apparentlymart/failinator/client/README.md

Failinator Client
=================

The *client* portion of Failinator is what runs on the Raspberry Pi and controls
the devices on the custom PCB.

It connects to the server to recieve push notifications of data via a
websocket connection.
