apparentlymart/failinator/pcb/failinator.kicad_pcb

## KiCad design pcb/failinator.kicad_pcb (2016-02-22)

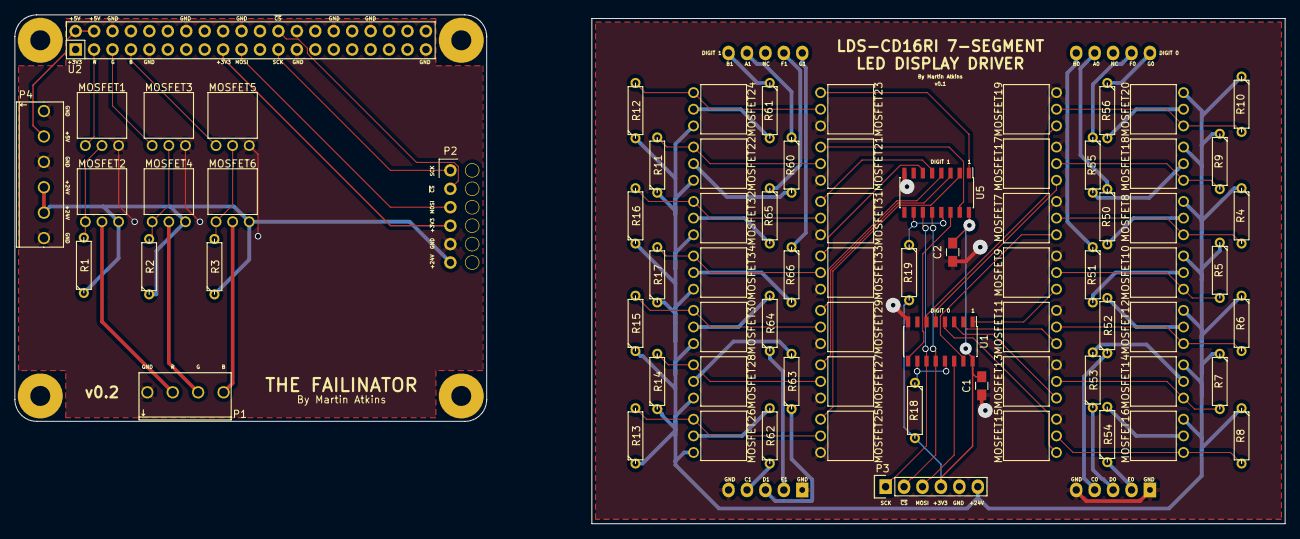
[picture p1: board failinator.kicad_pcb from above]

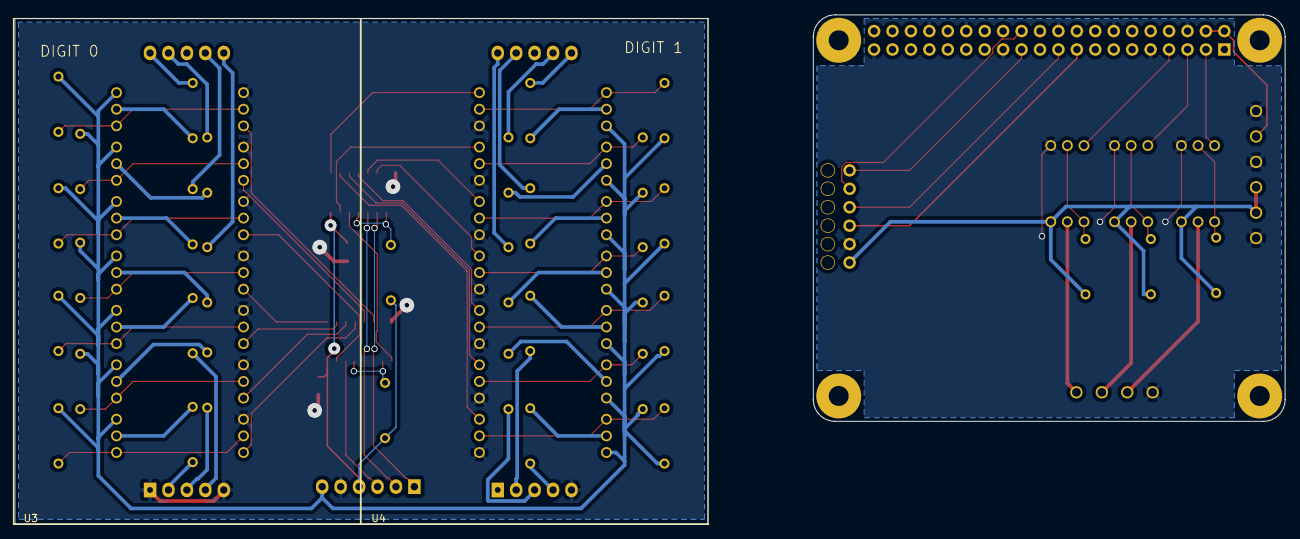
[picture p2: board failinator.kicad_pcb from below]

Board: 2 copper layers, 175.0 x 70.1 mm, 82 parts (2 on the bottom side), 81 nets.

Parts:
C1, C2: C_Small; C_0805_HandSoldering
MOSFET1, MOSFET3, MOSFET5, MOSFET7, MOSFET9, MOSFET11, MOSFET13, MOSFET15, MOSFET17, MOSFET19, MOSFET21, MOSFET23, MOSFET25, MOSFET27, MOSFET29, MOSFET31, MOSFET33: FQU13N06L; TO-251AA
MOSFET2, MOSFET4, MOSFET6, MOSFET8, MOSFET10, MOSFET12, MOSFET14, MOSFET16, MOSFET18, MOSFET20, MOSFET22, MOSFET24, MOSFET26, MOSFET28, MOSFET30, MOSFET32, MOSFET34: FQU17P06; TO-251AA
Mounting_Hole_2.75mm, Mounting_Hole_2.75mm#2, Mounting_Hole_2.75mm#3, Mounting_Hole_2.75mm#4: VAL**; Mounting_Hole_2.75mm
P1: CONN_01X04; TERM_4
P2: CONN_01X06; Wire_Conn_6pin_StrainReliefRight
P3: CONN_01X06; Pin_Header_Straight_1x06
P4: CONN_01X06; TERM_6
R1, R2, R3, R4, R5, R6, R7, R8, R9, R10, R11, R12, R13, R14, R15, R16, R17, R18, R19: 10k; R3
R50, R51, R52, R53, R54, R55, R56, R60, R61, R62, R63, R64, R65, R66: 150; R3
U1, U5: 74HC594; SOIC-16_3.9x9.9mm_Pitch1.27mm
U2: RASPIPLUSHEADER; Pin_Header_Straight_2x20
U3, U4: LDS-CD16RI

Connections:
+3V3: P2.4, U2.1, U2.17
+5V: P4.2, U2.2, U2.4
+24V: MOSFET2.3, MOSFET4.3, MOSFET6.3, P2.6, P4.4, P4.5, R1.1, R2.1, R3.1
/AmberDriver/EN: MOSFET3.1, U2.5
/AmberDriver/VOUT: MOSFET4.2, P1.3
/DISP_CS: P2.2, U2.24
/D_+3V3: C1.2, C2.2, P3.4, R18.2, R19.2, U1.16, U5.16
/D_DISP_CS: P3.2, U1.12, U5.12
/D_MOSI: P3.3, U1.14
/D_SCLK: P3.1, U1.11, U5.11
/DisplayDrivers/A0Driver/VOUT: MOSFET8.2, R50.2
/DisplayDrivers/A0_L: MOSFET7.1, U1.15
/DisplayDrivers/A0_P: R50.1, U3.7
/DisplayDrivers/A1Driver/VOUT: MOSFET22.2, R60.2
/DisplayDrivers/A1_L: MOSFET21.1, U5.15
/DisplayDrivers/A1_P: R60.1, U4.7
/DisplayDrivers/B0Driver/VOUT: MOSFET10.2, R51.2
/DisplayDrivers/B0_L: MOSFET9.1, U1.1
/DisplayDrivers/B0_P: R51.1, U3.6
/DisplayDrivers/B1Driver/VOUT: MOSFET24.2, R61.2
/DisplayDrivers/B1_L: MOSFET23.1, U5.1
/DisplayDrivers/B1_P: R61.1, U4.6
/DisplayDrivers/C0Driver/VOUT: MOSFET12.2, R52.2
/DisplayDrivers/C0_L: MOSFET11.1, U1.2
/DisplayDrivers/C0_P: R52.1, U3.4
/DisplayDrivers/C1Driver/VOUT: MOSFET26.2, R62.2
/DisplayDrivers/C1_L: MOSFET25.1, U5.2
/DisplayDrivers/C1_P: R62.1, U4.4
/DisplayDrivers/D0Driver/VOUT: MOSFET14.2, R53.2
/DisplayDrivers/D0_L: MOSFET13.1, U1.3
/DisplayDrivers/D0_P: R53.1, U3.3
/DisplayDrivers/D1Driver/VOUT: MOSFET28.2, R63.2
/DisplayDrivers/D1_L: MOSFET27.1, U5.3
/DisplayDrivers/D1_P: R63.1, U4.3
/DisplayDrivers/E0Driver/VOUT: MOSFET16.2, R54.2
/DisplayDrivers/E0_L: MOSFET15.1, U1.4
/DisplayDrivers/E0_P: R54.1, U3.2
/DisplayDrivers/E1Driver/VOUT: MOSFET30.2, R64.2
/DisplayDrivers/E1_L: MOSFET29.1, U5.4
/DisplayDrivers/E1_P: R64.1, U4.2
/DisplayDrivers/F0Driver/VOUT: MOSFET18.2, R55.2
/DisplayDrivers/F0_L: MOSFET17.1, U1.5
/DisplayDrivers/F0_P: R55.1, U3.9
/DisplayDrivers/F1Driver/VOUT: MOSFET32.2, R65.2
/DisplayDrivers/F1_L: MOSFET31.1, U5.5
/DisplayDrivers/F1_P: R65.1, U4.9
/DisplayDrivers/G0Driver/VOUT: MOSFET20.2, R56.2
/DisplayDrivers/G0_L: MOSFET19.1, U1.6
/DisplayDrivers/G0_P: R56.1, U3.10
/DisplayDrivers/G1Driver/VOUT: MOSFET34.2, R66.2
/DisplayDrivers/G1_L: MOSFET33.1, U5.6
/DisplayDrivers/G1_P: R66.1, U4.10
/DisplayDrivers/GND: C1.1, C2.1, MOSFET7.3, MOSFET9.3, MOSFET11.3, MOSFET13.3, MOSFET15.3, MOSFET17.3, MOSFET19.3, MOSFET21.3, MOSFET23.3, MOSFET25.3, MOSFET27.3, MOSFET29.3, MOSFET31.3, MOSFET33.3, P3.5, U1.8, U3.1, U3.5, U4.1, U4.5, U5.8
/DisplayDrivers/VIN: MOSFET8.3, MOSFET10.3, MOSFET12.3, MOSFET14.3, MOSFET16.3, MOSFET18.3, MOSFET20.3, MOSFET22.3, MOSFET24.3, MOSFET26.3, MOSFET28.3, MOSFET30.3, MOSFET32.3, MOSFET34.3, P3.6, R4.1, R5.1, R6.1, R7.1, R8.1, R9.1, R10.1, R11.1, R12.1, R13.1, R14.1, R15.1, R16.1, R17.1
/GreenDriver/EN: MOSFET5.1, U2.7
/GreenDriver/VOUT: MOSFET6.2, P1.4
/MOSI: P2.3, U2.19
/RedDriver/EN: MOSFET1.1, U2.3
/RedDriver/VOUT: MOSFET2.2, P1.2
/SCLK: P2.1, U2.23
GND: MOSFET1.3, MOSFET3.3, MOSFET5.3, P1.1, P2.5, P4.1, P4.3, P4.6, U2.6, U2.9, U2.14, U2.20, U2.25, U2.30, U2.34, U2.39
unnamed: MOSFET1.2, MOSFET2.1, R1.2
unnamed: MOSFET3.2, MOSFET4.1, R2.2
unnamed: MOSFET5.2, MOSFET6.1, R3.2
unnamed: MOSFET7.2, MOSFET8.1, R4.2
unnamed: MOSFET9.2, MOSFET10.1, R5.2
unnamed: MOSFET11.2, MOSFET12.1, R6.2
unnamed: MOSFET13.2, MOSFET14.1, R7.2
unnamed: MOSFET15.2, MOSFET16.1, R8.2
unnamed: MOSFET17.2, MOSFET18.1, R9.2
unnamed: MOSFET19.2, MOSFET20.1, R10.2
unnamed: MOSFET21.2, MOSFET22.1, R11.2
unnamed: MOSFET23.2, MOSFET24.1, R12.2
unnamed: MOSFET25.2, MOSFET26.1, R13.2
unnamed: MOSFET27.2, MOSFET28.1, R14.2
unnamed: MOSFET29.2, MOSFET30.1, R15.2
unnamed: MOSFET31.2, MOSFET32.1, R16.2
unnamed: MOSFET33.2, MOSFET34.1, R17.2
unnamed: R18.1, U1.10, U1.13
unnamed: R19.1, U5.10, U5.13
unnamed: U1.9, U5.14
