apparentlymart/failinator/(commit log)

2015-09-25 KiCad project.
2015-09-25 Pi Hat PCB mounting hole footprint.
2015-09-25 Project-specific footprint library.
2015-09-25 Component footprint assignments and netlist.
    [failinator.sch]
2015-09-25 Initial PCB floorplan.
    [failinator.kicad_pcb]
2015-09-25 Swap the external lamp connections for easier PCB routing.
    [failinator.kicad_pcb, failinator.sch]
2015-09-25 Design rules and ground pour.
    [failinator.kicad_pcb]
2015-09-25 PCB tracks.
    [failinator.kicad_pcb]
2015-09-25 Silkscreen annotations.
    [failinator.kicad_pcb]
2015-09-25 Change LED display pinout for a different display.
    The other display was too expensive, so switching to a smaller one.
    [failinator.kicad_pcb, failinator.sch]
2015-09-25 Re-fill polygons.
    [failinator.kicad_pcb]
2015-10-09 webhooks & website
    - added a new webhooks endpoint to receive VO events
    - more website styling
    - trigger events from the website
    - switch website to jquery
    - turn off ws test client writes
    - fix some event logic
2016-01-02 CircuitJS model of new 7seg display driver design.
2016-01-02 Starting work on revision v0.2.
    [failinator.kicad_pcb, failinator.sch]
2016-01-02 Factor out the MOSFET switches into a separate sheet.
    There will be a lot more of these soon once we start using a similar
    pattern to switch the LED segments.
    [MOSFETDriver.sch, failinator.kicad_pcb, failinator.sch]
2016-01-02 Remove the MAX7219-based digit driver sub-circuit
    The digit driver on v0.1 was not correct, providing only 5V to LED
    segments that have a forward voltage of more like 27V, causing them to
    not show at all.
    A replacement for this will be added in a subsequent commit.
    [MOSFETDriver.sch, failinator.kicad_pcb, failinator.sch]
2016-01-02 Schematic symbol for 7-segment LED display
2016-01-02 Squeeze schematic layout to make more space.
    The 7 segment LED driver sub-circuits are going to take up a bunch of
    space.
    [MOSFETDriver.sch, failinator.sch]
2016-01-02 7-segment LED displays and their ground connections
    [failinator.sch]
2016-01-02 KiCad's ongoing fiddling with the shared component refs
    When using the same child schematic sheet multiple times, KiCad keeps
    updating the references to point to the last one that was viewed/edited.
    So this change doesn't actually do anything.
    [MOSFETDriver.sch]
2016-01-02 Connect the LED controller CS to RPi pin 24.
    In the v0.1 design this was erroneously connected to pin 22, which is not
    supported as a hardware SPI chip select. Pin 24 is SPI0_CE0_N, which is
    the chip select pin for the first (zeroth) SPI device on the primary SPI
    bus.
    [failinator.sch]
2016-01-02 Tweak layout of the "Status Lamp Control" area
    Just a minor cosmetic tweak to improve the visual balance.
    [failinator.sch]
2016-01-02 Title on the MOSFETDriver sheet
    [MOSFETDriver.sch]
2016-01-02 Random updates to the KiCad project file
2016-01-11 MOSFET driver circuits for the 7-segment displays
    [DisplayDrivers.sch, MOSFETDriver.sch, failinator.sch]
2016-01-11 74HC594 schematic symbol
2016-01-11 Shift registers for the 7-seg displays
    [failinator.sch]
2016-02-21 Display board connects via 6-wire connector
    [DisplayDrivers.sch, MOSFETDriver.sch, failinator.sch]
2016-02-21 MOSFET resistor numbering
    [MOSFETDriver.sch]
2016-02-21 Shift register decoupling caps
    [failinator.sch]
2016-02-21 Some footprint assignments
    [MOSFETDriver.sch, failinator.sch]
2016-02-21 Remaining footprint assignments
    [failinator.sch]
2016-02-21 Start of 7seg display board floor planning
    [failinator.kicad_pcb]
2016-02-21 Use through-hole footprints for all display board resistors
    Previously two of them were incorrectly set to 0805 SMD footprints.
    I actually expect the display board layout is going to be very cramped
    so these might actually all become 0805s later, but going to try with
    through-hole first because I don't relish the thought of hand-soldering
    14 0805 resistors in a single sitting.
    [failinator.kicad_pcb, failinator.sch]
2016-02-21 Placement of display 0 MOSFETs and resistors
    [failinator.kicad_pcb]
2016-02-21 Initial work on traces for digit 0's MOSFETs
    [failinator.kicad_pcb]
2016-02-21 Ground plane for the LED display board
    [failinator.kicad_pcb]
2016-02-21 Shift register data connections
    [failinator.kicad_pcb]
2016-02-21 Digit 0 LED segment power traces
    [failinator.kicad_pcb]
2016-02-21 Shift register decoupling capacitors
    [failinator.kicad_pcb]
2016-02-21 Main board traces to the display board connector
    [failinator.kicad_pcb]
2016-02-21 Current-limiting resistors on the display segments
    Missed these on the first pass because I copied the drivers from the
    RYG tower but forgot that they have integrated resistors.
    [DisplayDrivers.sch]
2016-02-21 Rework digit 0 layout for current-limiting resistors
    [failinator.kicad_pcb]
2016-02-21 Place some grounds better so they are in the main copper pour
    [failinator.kicad_pcb]
2016-02-21 Placement of components for digit 1
    [failinator.kicad_pcb]
2016-02-21 Digit 1 traces
    [failinator.kicad_pcb]
2016-02-21 Move the 7seg display board into a more sensible position
    [failinator.kicad_pcb]
2016-02-21 Silkscreen title
    [failinator.kicad_pcb]
2016-02-22 Silkscreen labels for the various connections
    [failinator.kicad_pcb]
2016-02-22 Possibly overboard on the silkscreen labels
    The complete lack of labels last time made debugging difficult, so I'm
    now going to the other extreme of labeling basically everything in case
    we end up needing to attach probes or do more bodging this time around.
    [failinator.kicad_pcb]
2016-05-30 Adjust for the shift register on the v0.2 board
    This replaces the dedicated Maxim LED driver IC with an 8-bit shift
    register with a bunch of MOSFETs, so that the digits can be driven at
    24V rather than just 5V.
